KhomutovEvgeniy/USB_to_I2C/Lab_1.jpg

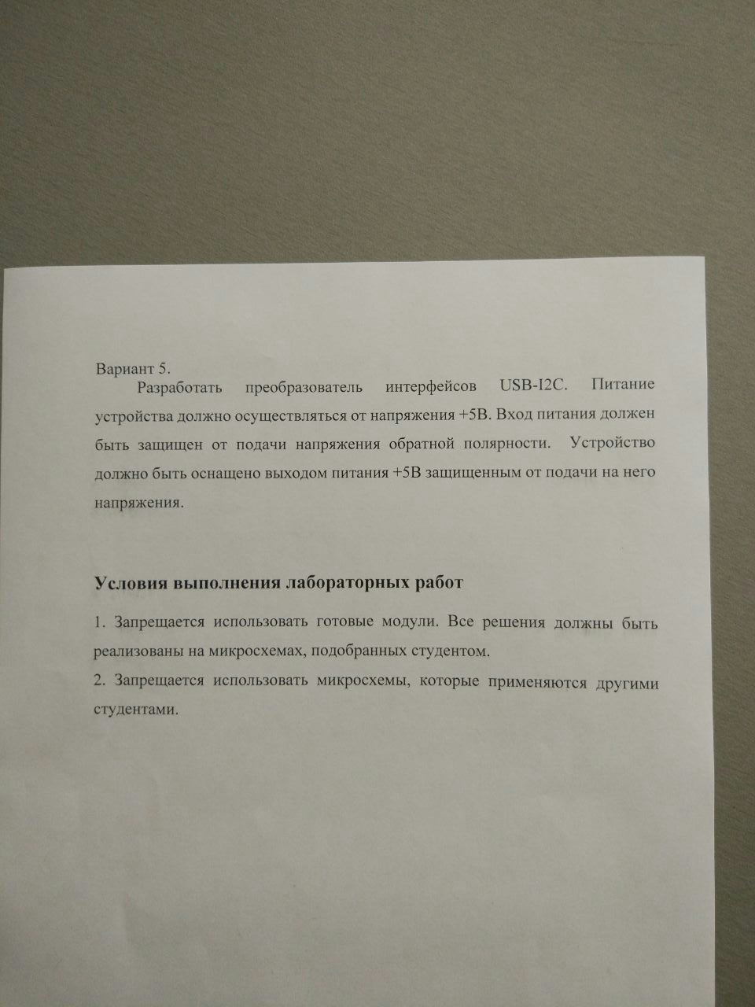
Lab_1.jpg
