KhomutovEvgeniy/USB_to_I2C/README.md

# USB_to_I2C
Преобразователь интерфейсов Usb - I2C на базе микросхемы CP2112
