KhomutovEvgeniy/USB_to_I2C/(list of files, drawings)

Other design files:
dc_dc_buck_converter.schdoc
Usb_to_i2c.PrjPcb
Usb_to_i2c.schdoc
Преобразователь интерфейсов.SchDoc
Преобразователь напряжения.SchDoc
Приставка преоб напряжений и интерфейсов.SchDoc
Приставка.PcbDoc
