KhomutovEvgeniy/USB_to_I2C/(commit log)

2018-11-13 Добавил схему и трассировку на проверку Васе
    [Usb_to_i2c.PrjPcb, Usb_to_i2c.schdoc, usb_to_i2c.PcbDoc]
2018-11-16 С четырехслойной перешел на двухслойную. USB гнездо заменил штекером USB 2.0 A. Трассировку сделал, необ показать Василию.
    [Usb_to_i2c.PrjPcb, Usb_to_i2c.schdoc, usb_to_i2c.PcbDoc]
2018-11-16 Исправил варнинги.
    [usb_to_i2c.PcbDoc]
2018-11-26 Обрезал полигон вокруг крепежных отверстий. На проверку
    [Usb_to_i2c.schdoc, usb_to_i2c.PcbDoc]
2018-12-13 Проект выполнен.
    [Usb_to_i2c.PrjPcb, Usb_to_i2c.schdoc, usb_to_i2c.PcbDoc]
2018-12-13 Добавил отчет по лабораторной работе (принят).
2018-12-20 Проверить версию с программируемым стабилитроном на воход подачи напряжения.
    [Usb_to_i2c.PrjPcb, Usb_to_i2c.schdoc, dc_dc_buck_converter.PcbDoc, dc_dc_buck_converter.schdoc, Приставка преоб напряжений и интерфейсов.SchDoc]
2018-12-20 Закончил с проектированием приставки. Необ проверка.
    [Usb_to_i2c.PrjPcb, dc_dc_buck_converter.PcbDoc, Преобразователь интерфейсов.SchDoc, Преобразователь напряжения.SchDoc, Приставка.PcbDoc]
